PNSP0/TSL/web/assets/readme/1-1.jpeg

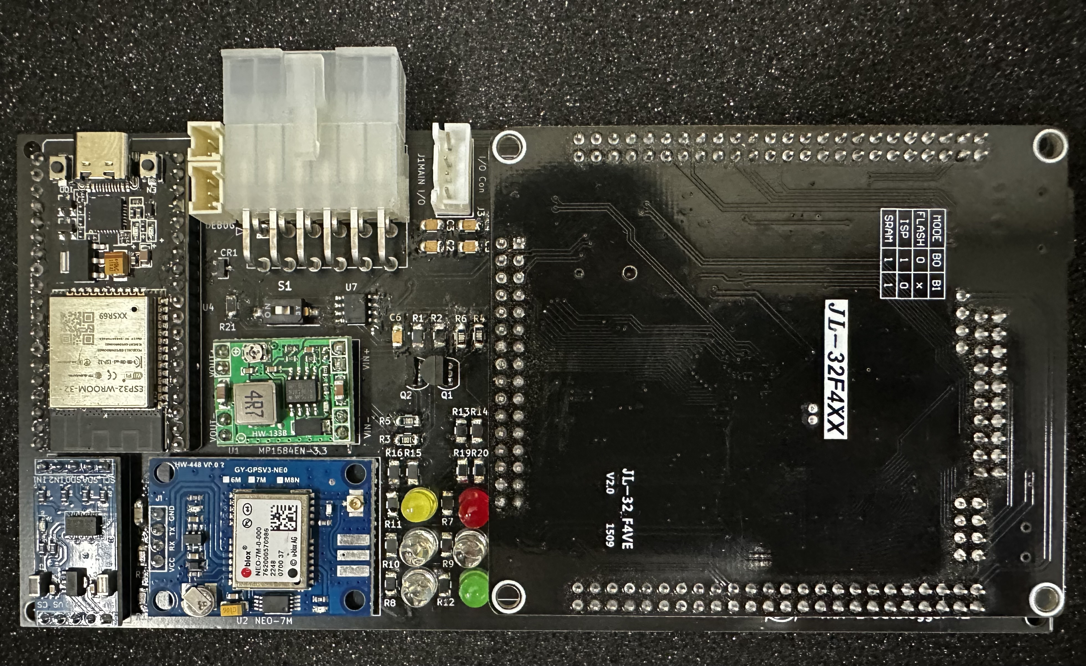
web/assets/readme/1-1.jpeg
