PNSP0/TSL/web/assets/readme/3-1.jpeg

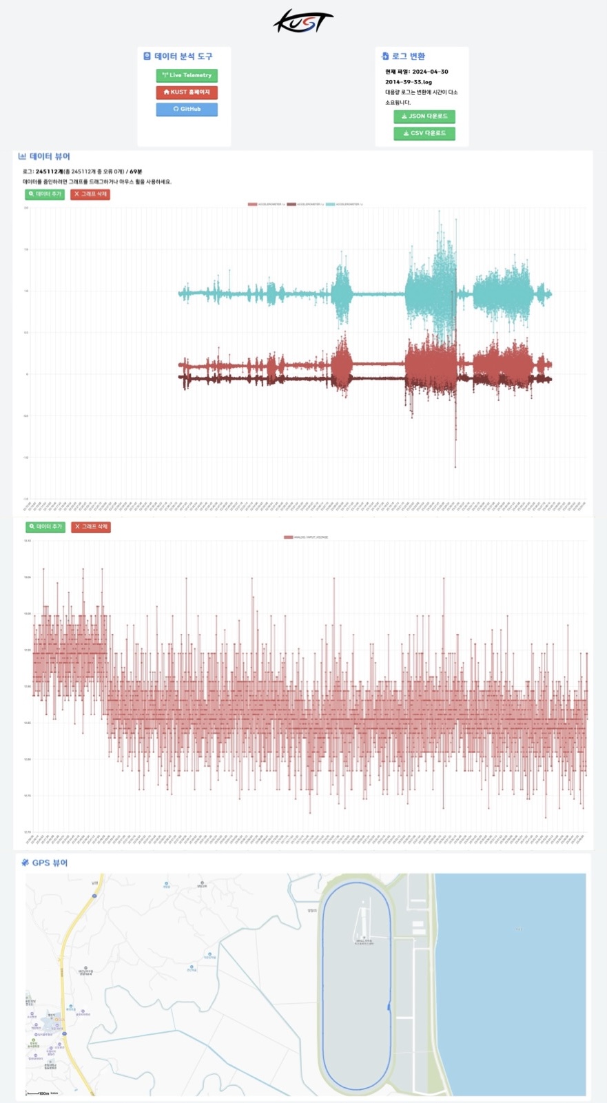
web/assets/readme/3-1.jpeg
