PNSP0/TSL/wiki/Wikihome.md

`KDL`의 사용가이드입니다.

# 데이터로거
1. [KDL 가이드](https://github.com/commanderk9826/KDL-distribution/wiki/KDL-가이드)

2. [PCB 가이드](https://github.com/commanderk9826/KDL-distribution/wiki/PCB-가이드)

3. [ESP32 가이드](https://github.com/commanderk9826/KDL-distribution/wiki/ESP32-가이드)

# 텔레메트리 모니터
4. [클라이언트 활용 가이드](https://github.com/commanderk9826/KDL-distribution/wiki/클라이언트-활용-가이드)

# 데이터 분석 도구

5. [데이터 분석 도구 가이드](https://github.com/commanderk9826/KDL-distribution/wiki/데이터-분석-도구-가이드)

# 기타

6. [서버 구축 가이드](https://github.com/commanderk9826/KDL-distribution/wiki/서버-구축-가이드)

7. [로그 프로토콜](https://github.com/commanderk9826/KDL-distribution/wiki/로그-프로토콜)

8. [웹 활용 가이드](https://github.com/commanderk9826/KDL-distribution/wiki/웹-활용-가이드)

9. [클라이언트 사용 가이드(KUST배포용)](https://github.com/commanderk9826/KDL-distribution/wiki/클라이언트-사용-가이드(KUST배포용))
