PNSP0/TSL/wiki/서버 구축 가이드.md

대부분 기본으로 제공되는 텔레메트리 서버(commanderk.site)를 사용하면 되며, 서버를 구축할 필요가 없습니다.

> 기본 텔레메트리 서버를 사용하려면 먼저 사용자 등록을 해야 함.
>
> lch9826@gmail.com 로 팀 이름, 사용할 차량 ID와 key를 보내세요.

별도로 서버를 구축하여 운영하고 싶은 경우에만 본 가이드를 따라 직접 서버를 self-hosting합니다.

기본적인 도메인 설정, Linux 명령어 등을 알고 있다고 가정하고 작성된 가이드입니다.

# 1. 도메인

서버로 사용할 도메인 주소를 구입하고, 해당 도메인 이름이 서버 IP 주소를 가리키도록 DNS 레코드를 설정합니다. 이용하는 도메인 업체에 따라 설정 과정이 달라지므로 본 가이드에서는 자세히 설명하지는 않습니다.

- [AWS EC2 (Linux 기반)Ubuntu 20.04LTS 인스턴스 생성](https://king-ja.tistory.com/99)
    
- [탄력적 IP 연결](https://soobarkbar.tistory.com/224)
    
- 인바운드 규칙 편집

     - SSH : 22

     - HTTP : 80

     - HTTPS : 443

     - 사용자 지정 TCP : <YOUR_MONOLITH_PORT>
        
- [가비아 도메인 발급](https://customer.gabia.com/manual/domain/287/1201)

# 2. NGINX

[Install NGINX](https://www.nginx.com/resources/wiki/start/topics/tutorials/install/) 문서에 따라 NGINX 웹 서버를 설치함.

- 참고
    
    ```bash
    sudo su
    
    apt-get update 
    
    apt-get install nginx -y
    
    nginx -v
    ```

# 3. KDL

KDL 저장소를 클론합니다.

```bash
git clone https://github.com/commanderk9826/KDL-distribution.git
cd KDL-distribution
```

# 4. Configuration

## NGINX 설정

<aside>
💡 KDL-distribution → KDL로 폴더 명 변경합니다.
</aside>

`KDL/server/KDL.conf` 파일을 열어 <YOUR_SERVER_DOMAIN>, <YOUR_SERVER_PORT>, <YOUR_SERVER_PATH>으로 표시된 부분을 바꿉니다.

- **<YOUR_SERVER_DOMAIN> :** 서버의 도메인 주소입니다. (ex. commanderk.site, www.commanderk.site)
- **<YOUR_SERVER_PORT> :**  서버가 실행되는 포트 주소입니다.`server/config.json` 과 함께 임의의 값으로 동일하게 설정합니다.
- **<YOUR_SERVER_PATH> : KDL** 저장소 경로입니다.

### SSL/TLS 설정

도메인 TLS 인증서를 발급받고 <YOUR_SSL_CERTIFICATES>자리에 `ssl_certificate`, `ssl_certificate_key`등 필요한 SSL 설정값들을 입력합니다.

 [Configuring HTTPS servers](https://nginx.org/en/docs/http/configuring_https_servers.html) 를 참고합니다.

다 설정했다면 파일을 NGINX 설정 파일 경로로 옮기고 NGINX를 재시작합니다.

```bash
sudo cp server/KDL.conf /etc/nginx/sites-available
cd /etc/nginx/sites-enabled
sudo ln -s ../sites-available/default default
sudo systemctl restart nginx
```

<aside>
💡 default(기존 NGINX 설정 파일)삭제하고, KDL.conf → default로 NGINX설정파일명 변경합니다.

</aside>

- [Let's Encrypt SSL 인증서 발급](https://www.owl-dev.me/blog/42)

## 서버 설정

### NPM 모듈 설치

`KDL/server` 경로에서 `npm install` 명령을 실행해 NPM 모듈들을 설치합니다.

### 채널 설정

`KDL/server/config.json` 파일의 `channels` 값을 설정합니다.

이 목록에 등록된 채널 name과 key를 가진 KDL만 클라이언트만 서버에 접속할 수 있습니다.

채널 key는 단순 검증을 위해 사용하는 값으로, secret이 아닙니다. 통신 전체에서 평문으로 처리됩니다.

### 포트 설정

`KDL/server/config.json` 파일의 `port` 값을 <YOUR_MONOLITH_PORT> 에서 앞서 NGINX에서 설정했던 값으로 변경합니다.

### Linux 서비스 등록

다음 명령을 실행해 KDL 서비스를 등록하고 실행합니다.

```bash
sudo cp KDL/server/KDL.service /etc/systemd/system
sudo systemctl daemon-reload
sudo systemctl enable KDL
sudo systemctl start KDL
```

# 5. 운영

`channels` 을 새로 등록하거나 수정하려면 `KDL/server/config.json` 값을 편집한 후 

`sudo systemctl restart KDL` 명령을 실행하면 됩니다.

모든 통신은 `KDL/server/log` 디렉터리에 날짜별로 구분되어 기록됩니다.
