PNSP0/TSL/wiki/웹 활용 가이드.md

다시 한번 말하자면, 별도로 서버를 구축하여 운영하고 싶은 경우에만 본 가이드를 따라 직접 서버를 self-hosting합니다. 기본적인 Html, JavaScript, CSS등 Frontend 분야 관련 지식 등을 알고 있다고 가정하고 작성된 가이드입니다.

# 1. Meta, Title

`KDL/web/index.html` 와`KDL/web/live/index.html` 파일의 meta, title 값을 설정합니다. 

```html
<meta charset="UTF-8">
		<meta name="viewport" content="width=device-width, initial-scale=1, user-scalable=no" />
		<meta property="og:title" content="KUST Data Analyzer"/>
		<meta property="og:url" content="https://www.commanderk.site"/>
		<meta property="og:image" content="https://www.commanderk.site/assets/logo/logo.png"/>
		<meta property="og:description" content="KUST Data Analysis Toolset"/>

    <title>KUST Data Analyzer</title>
```

[MetaTag란?](https://yozm.wishket.com/magazine/detail/816/)

# 2. og : image

`KDL/server/KDL.conf` 의 http 서버 location를 설정합니다. 

```
location = /logo {
   alias <YOUR_MONOLITH_PATH>/web/assets/logo;
  }
```

`KDL/web/index.html` 와`KDL/web/live/index.html` 파일의 property=”og : image”의 content를 경로에 맞게 설정해줍니다.

```html
<meta property="og:image" content="https://www.commanderk.site/assets/logo/logo.png"/>
```

[Nginx를 사용한 이미지 서버 구축](https://velog.io/@singsoong/Nginx%EB%A5%BC-%EC%82%AC%EC%9A%A9%ED%95%9C-%EC%9D%B4%EB%AF%B8%EC%A7%80-%EC%84%9C%EB%B2%84-%EA%B5%AC%EC%B6%95)

# 3. Favicon

[Favicon이란?](https://ko.wix.com/blog/post/what-is-favicon-how-to-make)

[Favicon 생성기](https://wizlogo.com/ko/favicon-generator)

# 4. KaKao Map API

Kakao 지도 Javscript API는 키 발급을 받아야 사용할 수 있습니다. [카카오API발급가이드](https://apis.map.kakao.com/web/guide/)를 따라 API를 발급해줍니다. 

`KDL/web/index.html` 와`KDL/web/live/index.html` 파일을 열어  <YOUR_KAKAOMAP_APIKEY>으로 표시된 부분을 바꿉니다. 

# 5. LatLng

`KDL/web/script.js` 와`KDL/web/live/script.js` 파일을 열어 초기에 GPS뷰어에서 나타내고 싶은 곳의 위도와 경도를 수정해줍니다.

```jsx
let map = new kakao.maps.Map(document.getElementById('map'), {
  center: new kakao.maps.LatLng(37.611709, 126.994029)
});
```

[위도, 경도 찾는 방법](https://letsplaycoding.tistory.com/26#google_vignette)
