PNSP0/TSL/wiki/클라이언트 활용 가이드.md

데이터로거가 전송한 데이터를 실시간으로 모니터링하기 위한 웹 클라이언트입니다.

[https://commanderk.site/live](https://commanderk.site/live) 에서 서비스됩니다.





# 1. 차량 ID 설정
우선 `차량 ID 설정` 버튼을 눌러 사용자 등록 시 정한 차량 ID와 key를 입력합니다.

차량 ID와 key는 여러 명이 공통으로 사용하는 텔레메트리 서버에서 각 팀을 구분하기 위한 용도입니다.

ID와 key를 입력하고 확인을 누르면 페이지가 새로고침되고 설정이 반영됩니다.



- 설정한 차량 ID와 key는 해당 브라우저에 저장됩니다. 다른 브라우저로 페이지에 접속하면 다시 설정해야 합니다.

# 2. UI 설정

`UI 설정` 버튼을 누르면 UI 설정 창이 표시됩니다.

UI는 여러 데이터를 묶는 데이터그룹과, 데이터그룹에 속한 데이터로 구성됩니다.

## 2-1. 데이터그룹


`데이터 그룹 추가` 버튼을 누르면 데이터그룹이 추가됨.



데이터그룹은 이름과 아이콘, 그리고 포함하고 있는 데이터로 이루어짐.

이름을 입력하고, 필요하다면 아이콘을 선택합니다. 옆의 `검색` 버튼을 눌러 사용 가능한 아이콘 이름을 검색할 수 있습니다.

`데이터 추가` 버튼을 누르면 데이터그룹에 데이터를 추가합니다.

## 2-2. 데이터


데이터는 다음과 같은 속성들을 가지고 있음.

- 이름
- 아이콘
- 디스플레이 타입
- 데이터 소스
- 데이터 배율
- 데이터 단위

데이터그룹과 같이 이름과 아이콘을 설정하고, 디스플레이 타입을 선택.

### 디스플레이 타입

웹 클라이언트는 4가지 디스플레이 타입을 지원함.

#### 1. *digital*

데이터 소스의 값이 0이라면 `OFF`, 0이 아니라면 `ON`을 표시하는 가장 단순한 디스플레이.



데이터 배율과 데이터 단위 설정을 지원하지 않음.

#### 2. *value*

데이터 소스의 값을 그대로 보여주는 디스플레이.



데이터 소스의 값에 배율을 곱한 값을 보여줌. 데이터 단위는 표시되는 값 우측에 작게 표시됨.

#### 3. *graph*

데이터 소스의 값과 함께 최근 1분간 그래프를 보여주는 디스플레이.



#### 4. *gps*

차량의 실시간 위치를 지도에서 보여주는 디스플레이.



데이터 소스, 배율, 단위 설정을 지원하지 않음.

자동으로 `GPS / lat`과 `GPS / lon` 값을 이용해 차량의 위치를 표시함.

### 데이터 소스

데이터 소스는 일반 데이터 소스와 CAN 데이터 소스로 구분.

### 일반 데이터 소스

CAN 트래픽을 제외한 나머지는 모두 일반 데이터로 분류.



설정 도구에서 `일반` 을 선택한 후, 아래 드롭다운 메뉴에서 소스를 선택.

### CAN 데이터 소스

8 byte로 구성된 하나의 CAN 메시지는 다음 예시처럼 대개 여러 정보를 포함.



CAN 메시지에서 특정 부분만을 분리해 데이터로 표시할 수 있음.



- **CAN ID**: CAN 메시지 ID를 설정함.
- **데이터 기본 단위**: CAN 메시지를 바이트 단위로 분리할 것인지, 비트 단위로 분리할 것인지 선택.
    - **Byte 단위**
        - Endian: 표시할 데이터가 CAN 메시지에 저장된 방식(엔디언)을 지정.
        - Byte #: 표시할 데이터를 가지고 있는 시작과 끝 바이트 번호를 지정.
    - **Bit 단위**
        - Bit #: 표시할 데이터를 가지고 있는 시작과 끝 비트 번호를 지정.

> **Bit 단위 데이터 분리 기능은 아직 지원하지 않음.**

## 2-3. UI export/import

UI 설정 또한 브라우저에 저장됨. 다른 브라우저를 사용하여 접속하면 UI를 새로 설정해야 함.

매번 UI를 일일히 다시 설정하지 않도록 UI 내보내기와 불러오기 기능을 지원함.

`UI 설정 내보내기` 버튼을 누르면 현재 설정된 UI가 `ui_config.json` 파일로 다운로드됨.

`UI 설정 불러오기` 버튼을 누르면 파일 업로드 팝업이 표시됨.



내보냈던 `ui_config.json` 파일을 선택하고 확인 버튼을 누르면, 해당 UI가 그대로 적용됨.

아래 샘플 UI 설정을 복사해 `ui_config.json` 파일로 저장하고 불러오면 미리 설정된 샘플 UI가 적용됨.

> [샘플 ui_config.json](https://github.com/commanderk9826/KDL-distribution/blob/main/ui_configKUST.json)
