PNSP0/TSL/web/assets/readme/1-4.jpeg

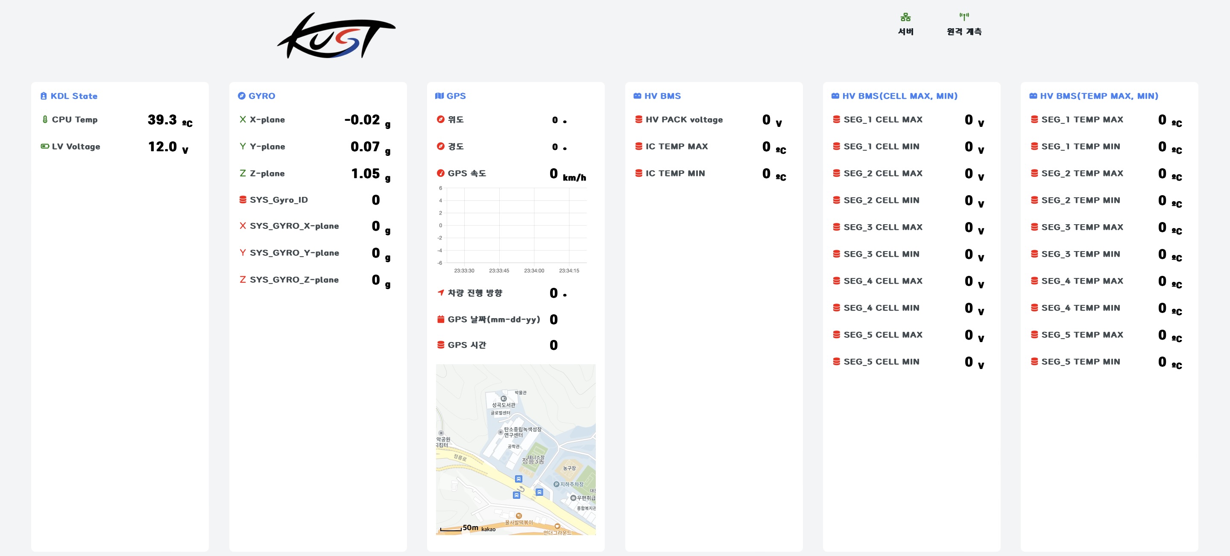
web/assets/readme/1-4.jpeg
