PNSP0/TSL/web/assets/readme/1-5.jpeg

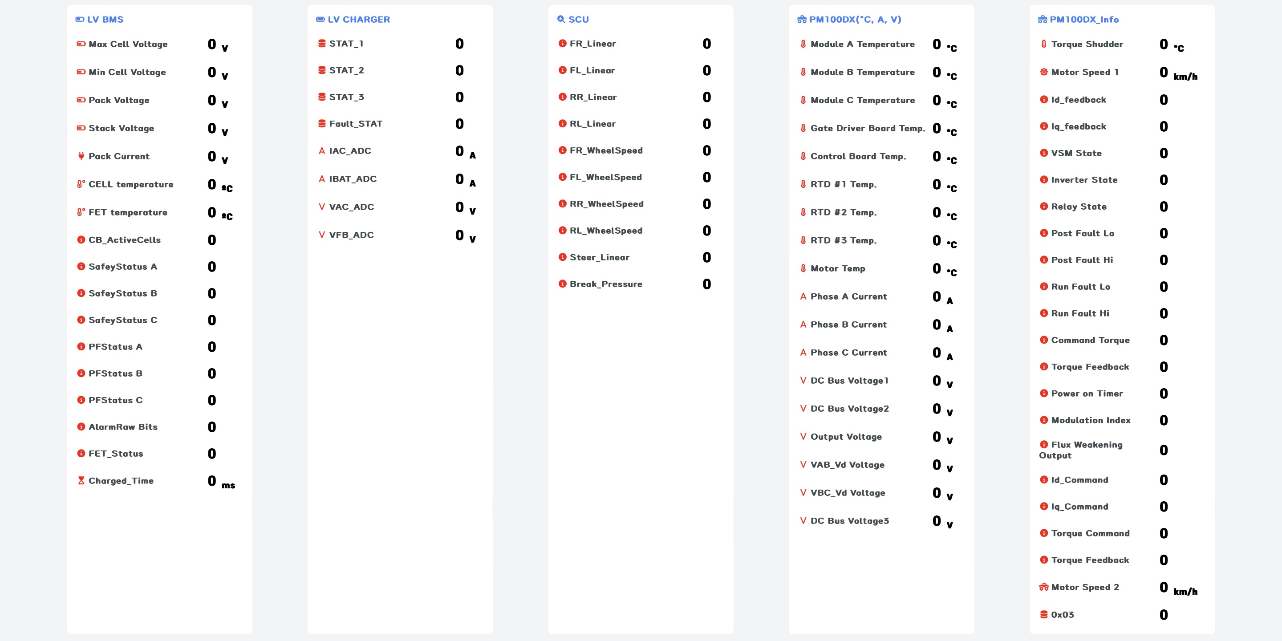
web/assets/readme/1-5.jpeg
