PNSP0/TSL/web/assets/readme/1-6.jpeg

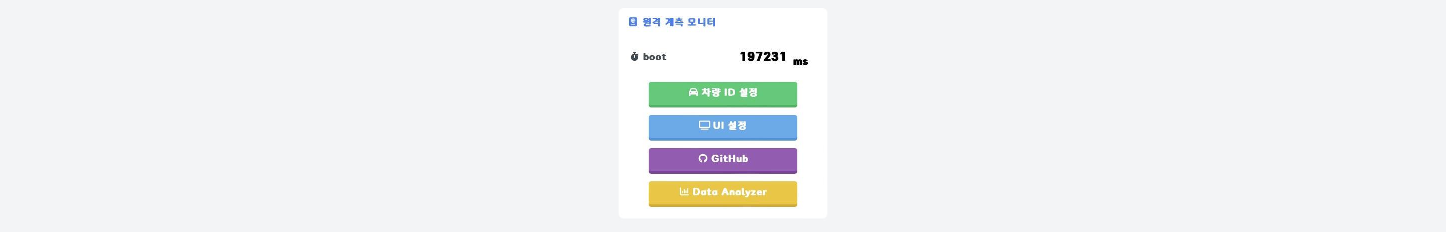
web/assets/readme/1-6.jpeg
