PNSP0/TSL/web/assets/readme/2-1.jpeg

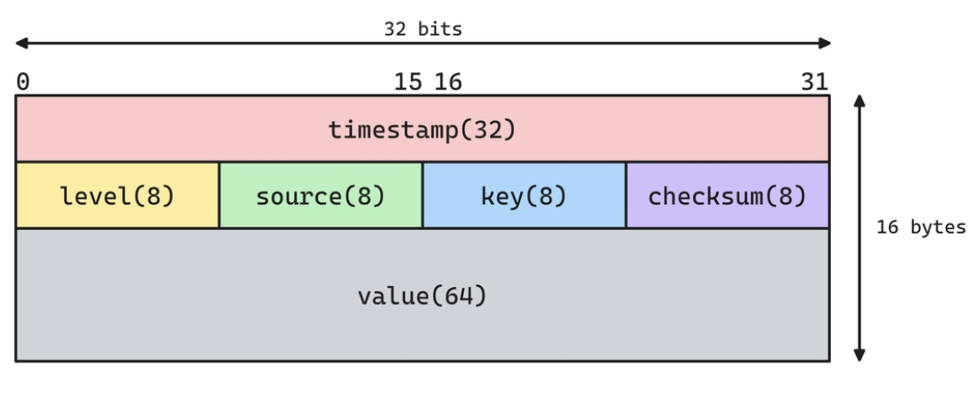
web/assets/readme/2-1.jpeg
