PNSP0/TSL/web/assets/readme/3-2.png

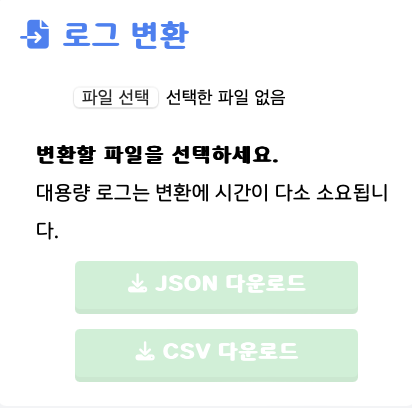
web/assets/readme/3-2.png
