PNSP0/TSL/web/assets/readme/3-3.png

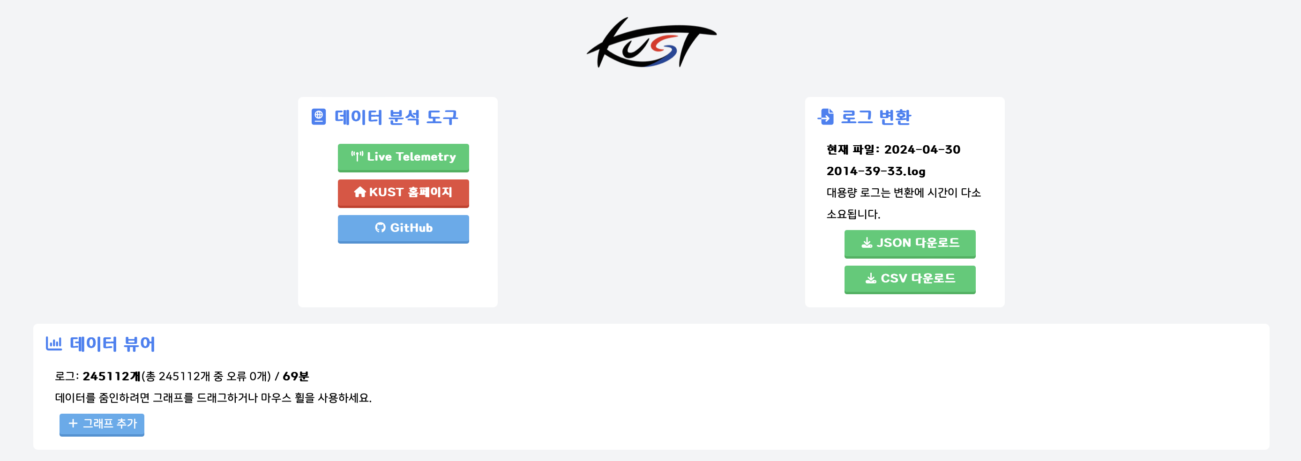
web/assets/readme/3-3.png
