PNSP0/TSL/web/assets/readme/4-2.png

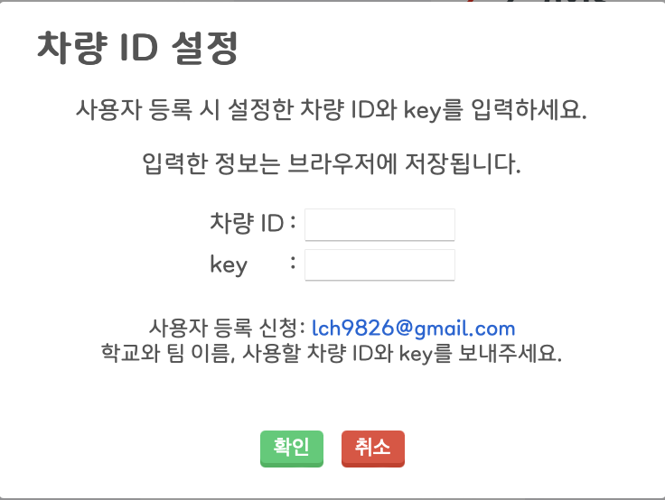
web/assets/readme/4-2.png
