PNSP0/TSL/web/assets/readme/4-3.png

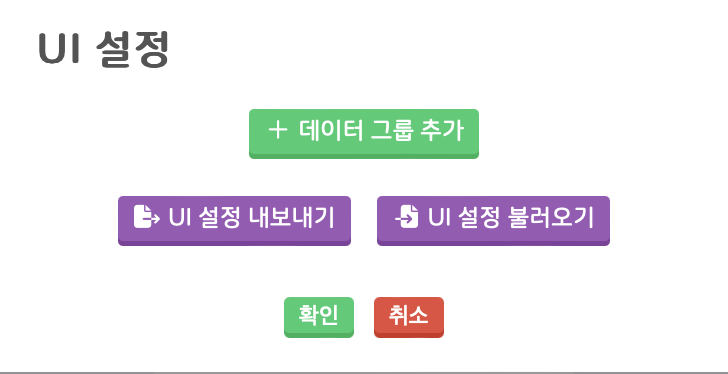
web/assets/readme/4-3.png
