PNSP0/TSL/web/assets/readme/4-4.png

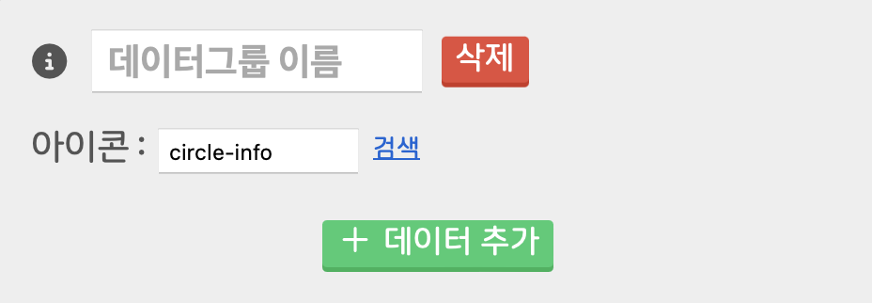
web/assets/readme/4-4.png
