PNSP0/TSL/web/assets/readme/4-5.png

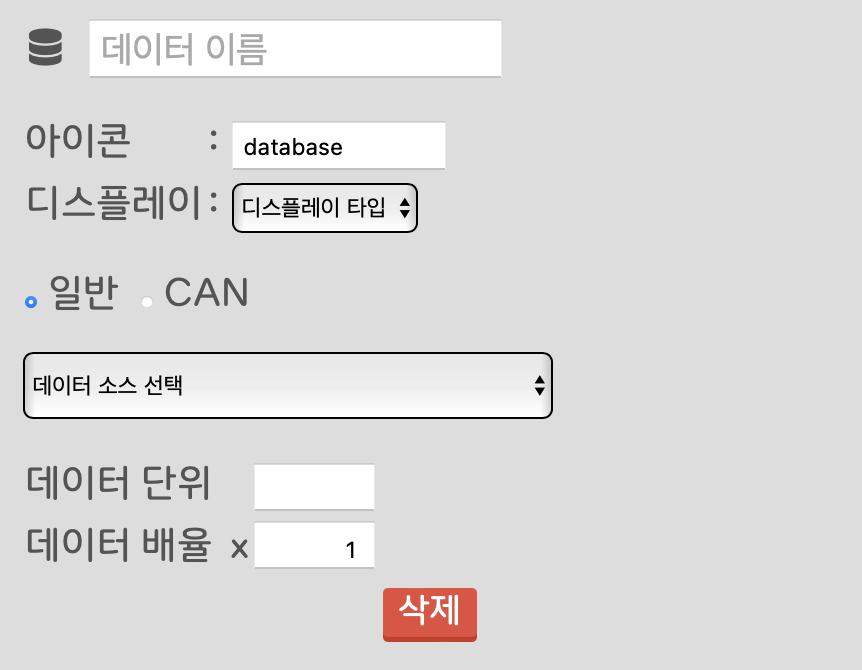
web/assets/readme/4-5.png
