PNSP0/TSL/web/assets/readme/4-8.png

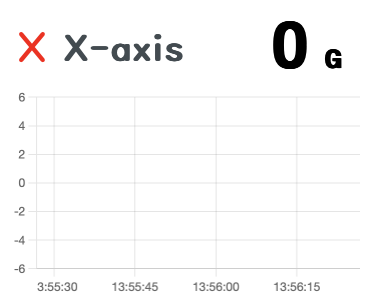
web/assets/readme/4-8.png
