PNSP0/TSL/web/assets/readme/4-9.png

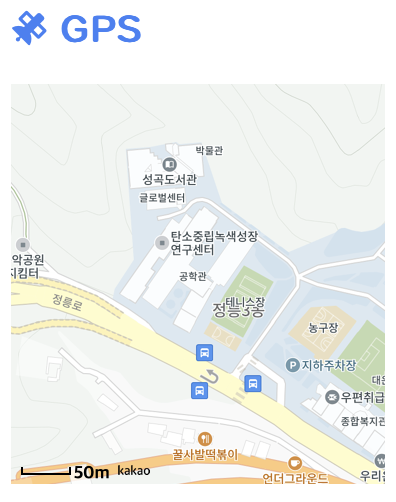
web/assets/readme/4-9.png
