PNSP0/TSL/web/assets/readme/4-10.png

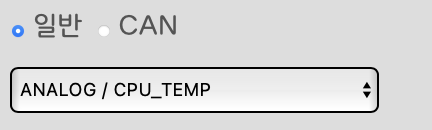
web/assets/readme/4-10.png
