PNSP0/TSL/web/assets/readme/4-11.jpeg

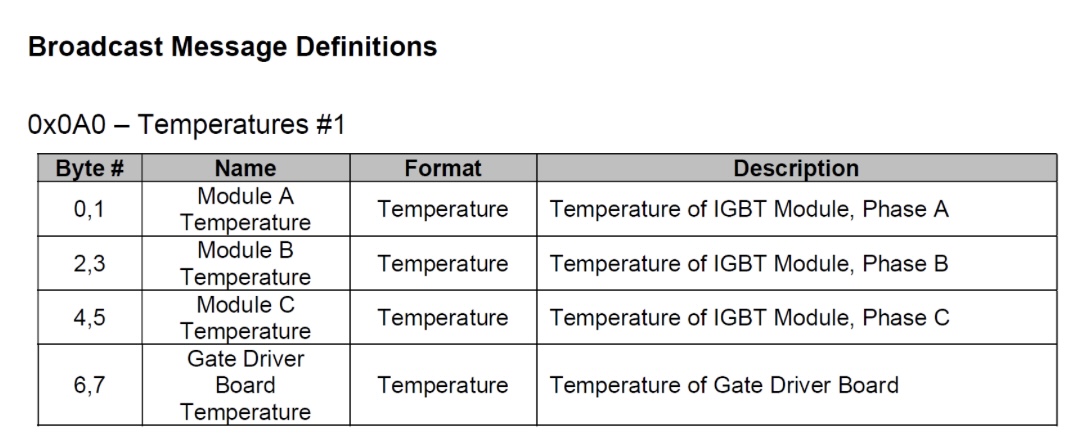
web/assets/readme/4-11.jpeg
