PNSP0/TSL/web/assets/readme/4-12.png

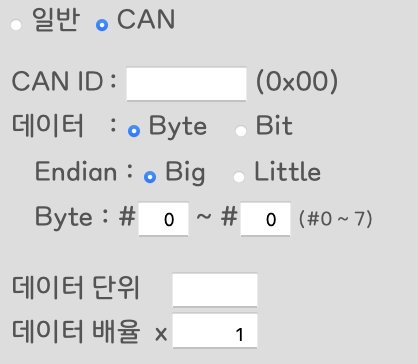
web/assets/readme/4-12.png
