PNSP0/TSL/web/assets/readme/4-13.png

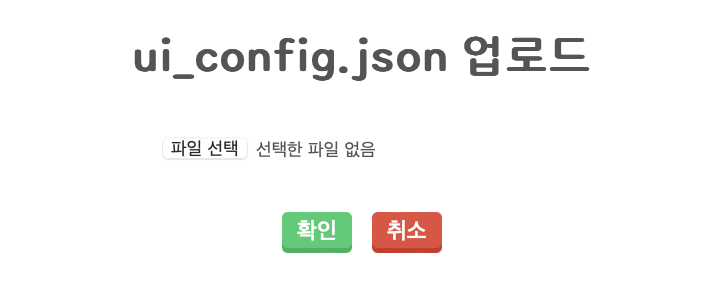
web/assets/readme/4-13.png
