PNSP0/TSL/web/assets/readme/5-1.jpeg

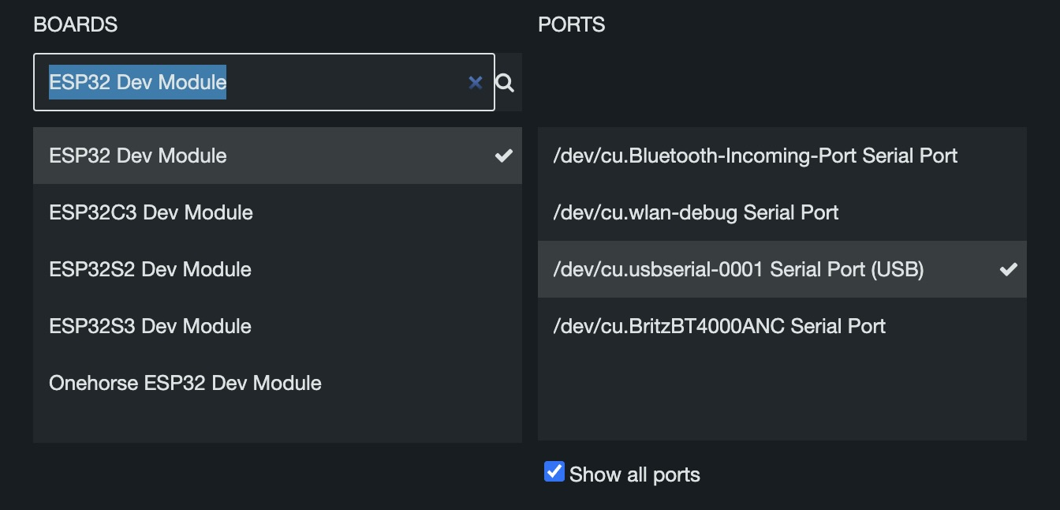
web/assets/readme/5-1.jpeg
