PNSP0/TSL/web/assets/readme/5-2.png

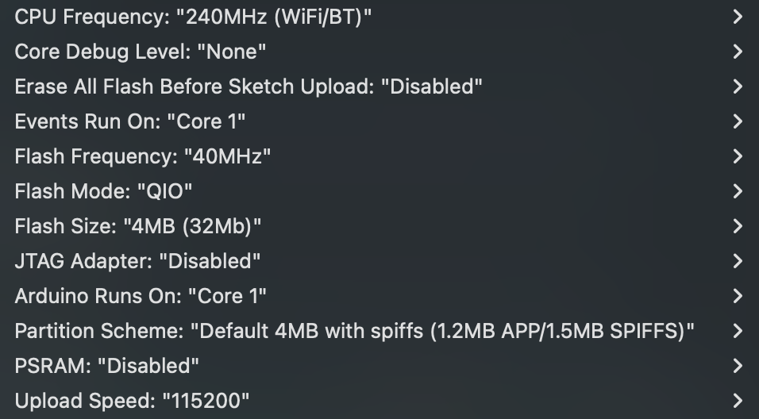
web/assets/readme/5-2.png
