PNSP0/TSL/web/assets/readme/5-3.jpeg

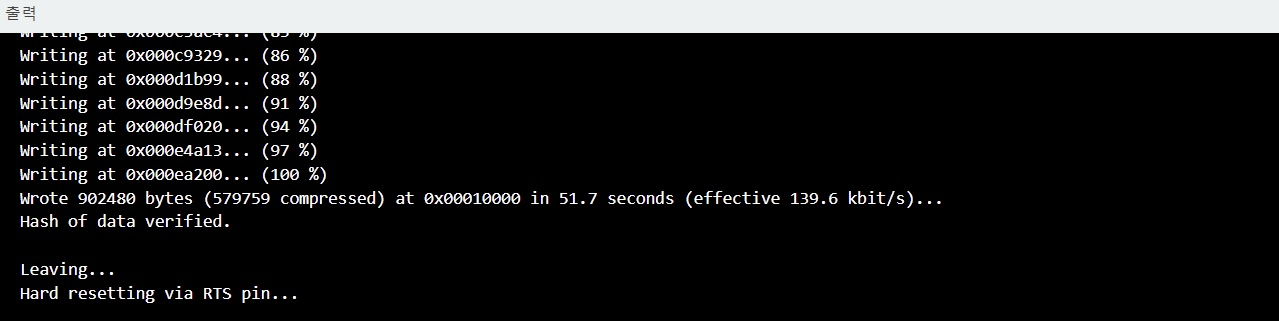
web/assets/readme/5-3.jpeg
