PNSP0/TSL/web/assets/readme/6-1.png

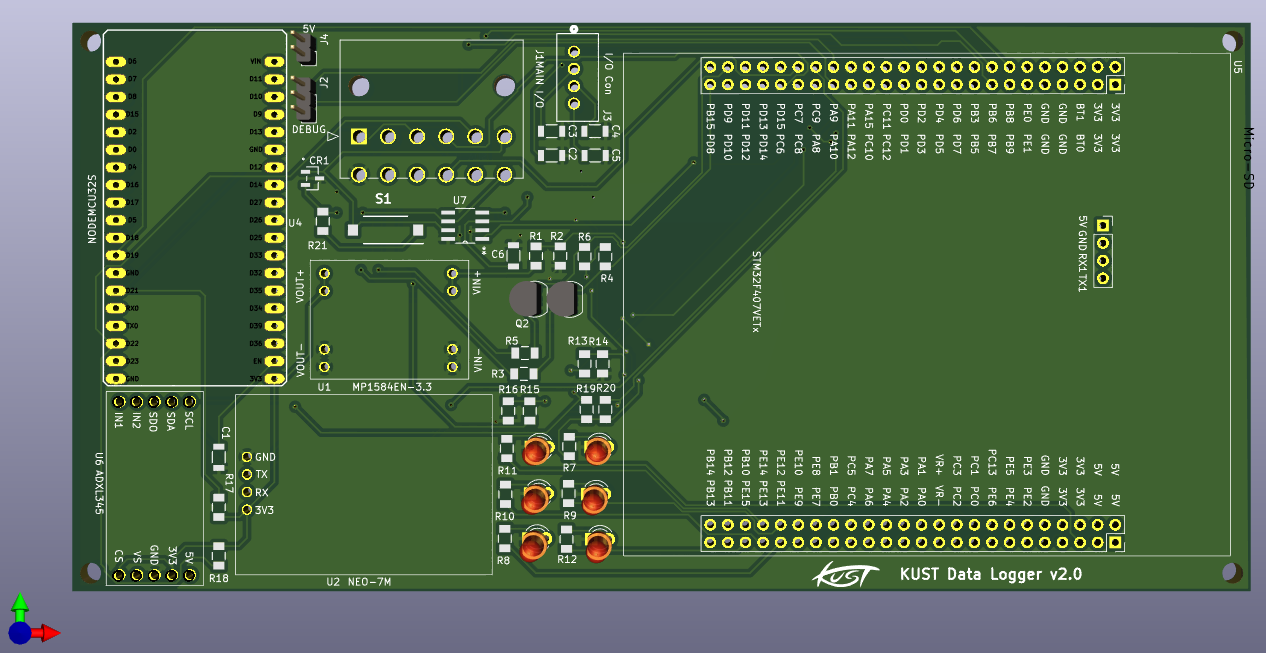
web/assets/readme/6-1.png
