PNSP0/TSL/web/assets/readme/6-2.png

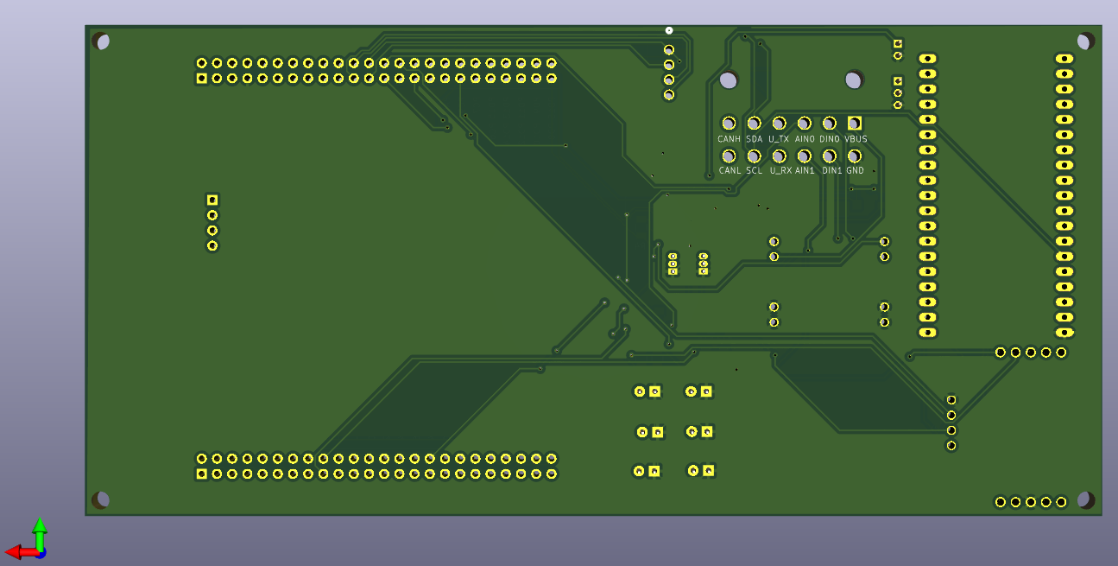
web/assets/readme/6-2.png
