PNSP0/TSL/web/assets/readme/7-2.png

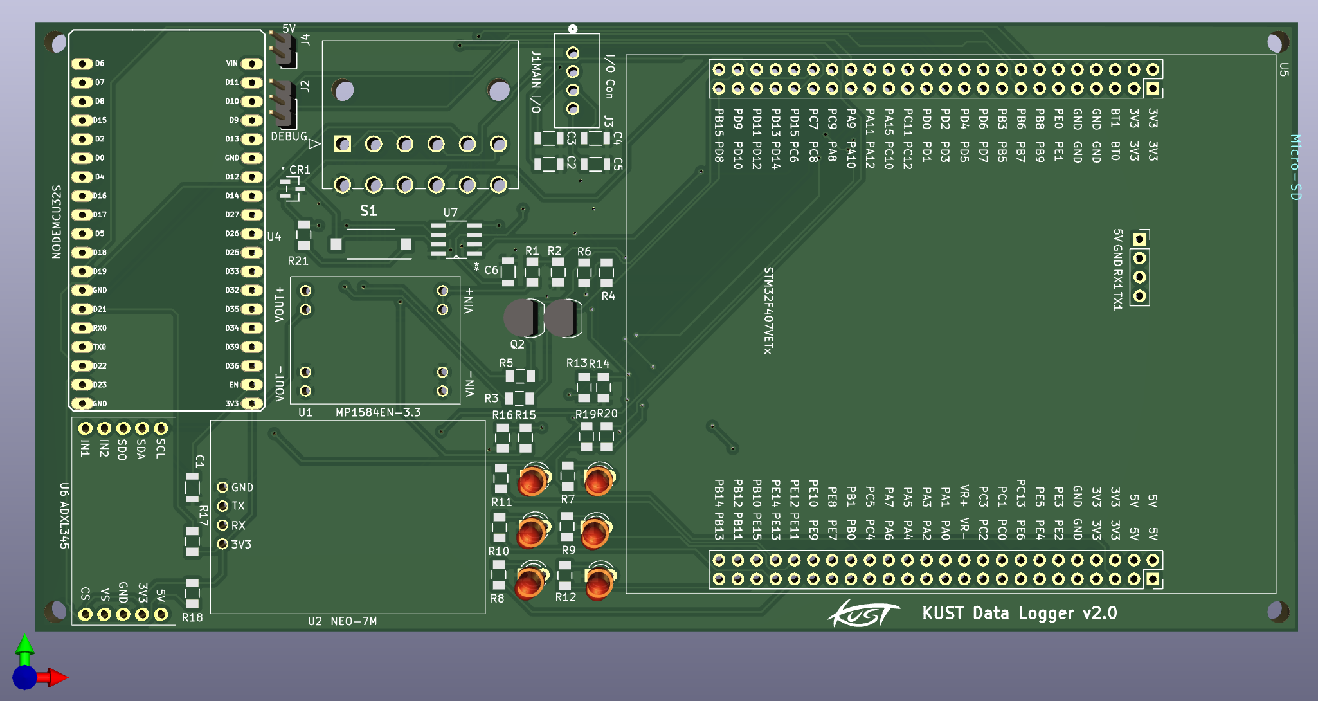
web/assets/readme/7-2.png
