PNSP0/TSL/web/assets/readme/7-3.png

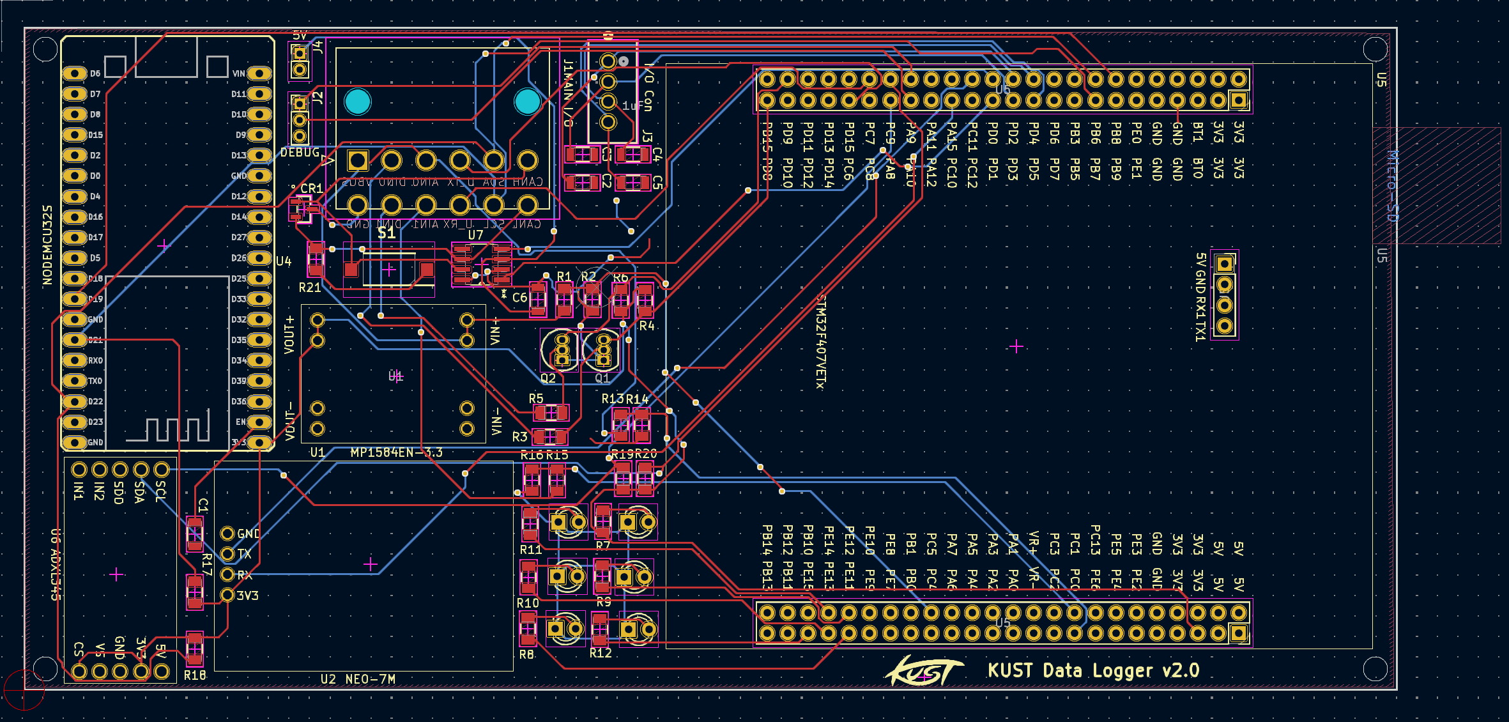
web/assets/readme/7-3.png
