PNSP0/TSL/web/assets/readme/7-4.png

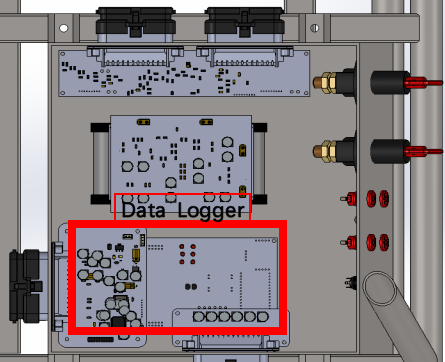
web/assets/readme/7-4.png
