PNSP0/TSL/web/assets/readme/7-5.jpeg

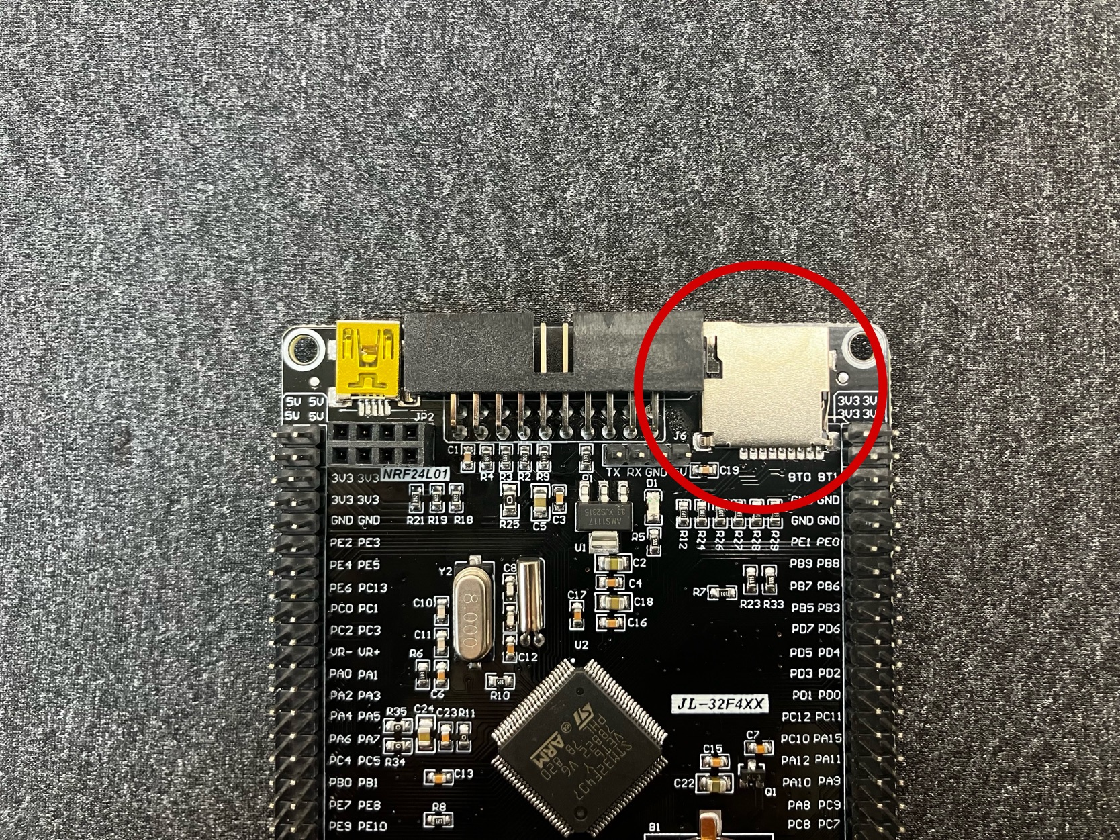
web/assets/readme/7-5.jpeg
