PNSP0/TSL/web/assets/readme/7-6.png

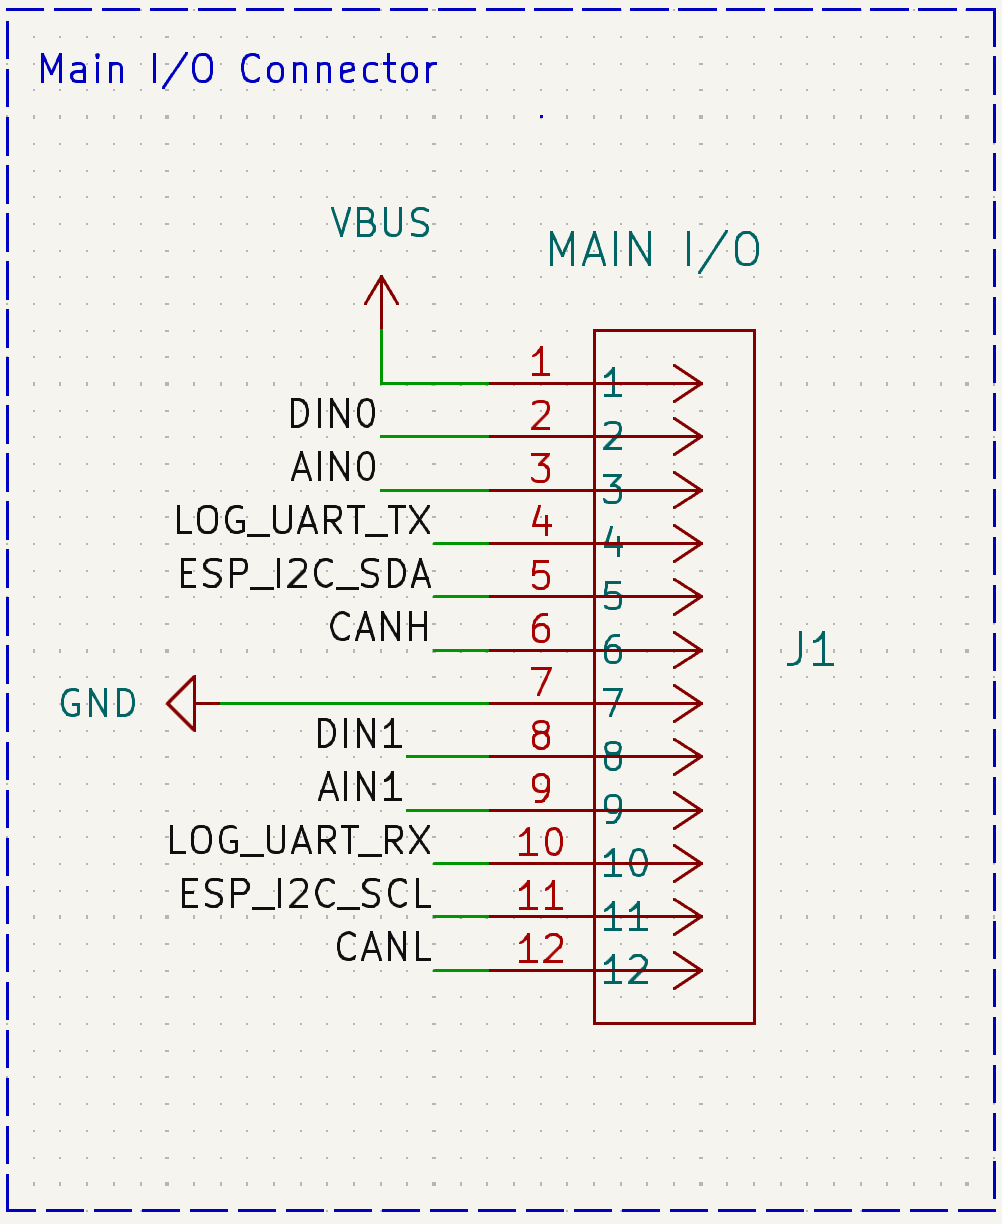
web/assets/readme/7-6.png
