PNSP0/TSL/web/assets/readme/7-8.png

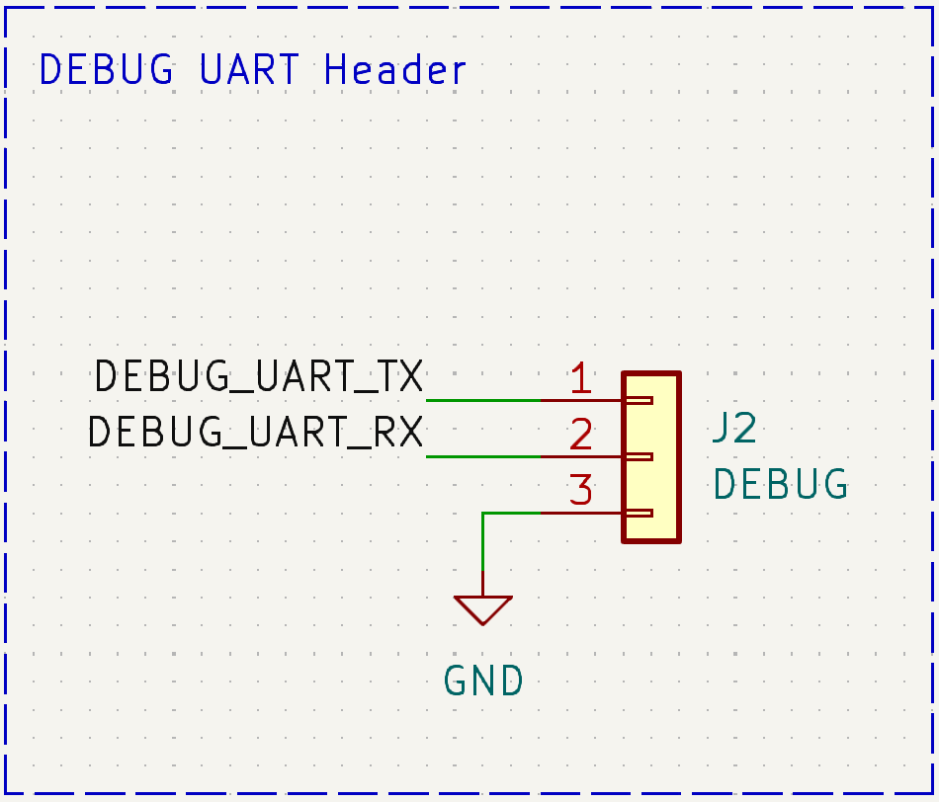
web/assets/readme/7-8.png
