PNSP0/TSL/web/assets/readme/7-10.png

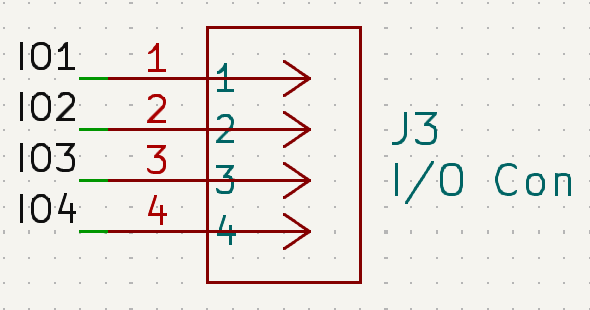
web/assets/readme/7-10.png
