PNSP0/TSL/web/assets/readme/7-12.png

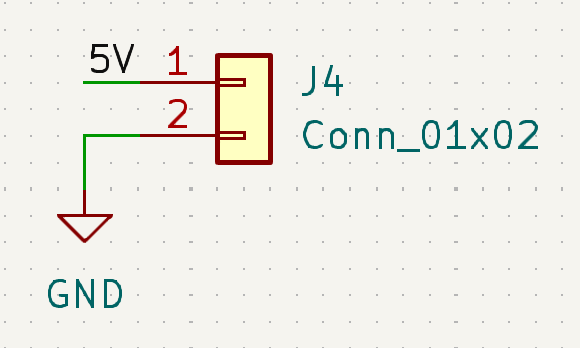
web/assets/readme/7-12.png
