PNSP0/TSL/(commit log)

2024-10-02 secont commit
    [devicemart.xlsx, eleparts.xls]
2024-11-01 third commit
    [devicemart.xlsx, eleparts.xls]
2024-11-11 로컬 변경 사항 커밋
